gjat/temp-controller/pics/programmer board.jpg

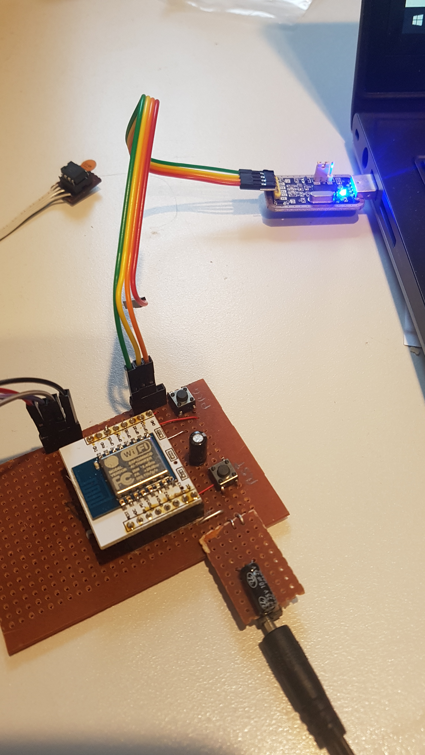
pics/programmer board.jpg
