gjat/temp-controller/pics/settings.png

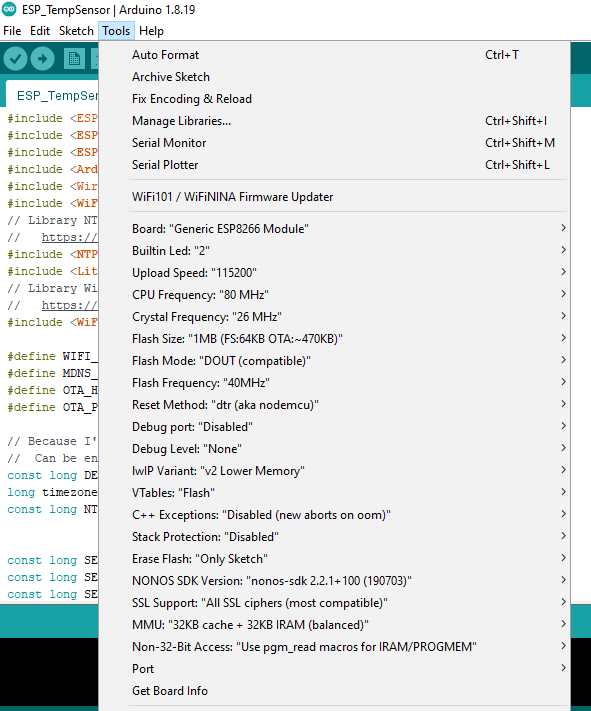
pics/settings.png
