gjat/temp-controller/(commit log)

2022-07-07 initial sensor test
2023-05-20 Update to provide resetting of min/max, and heater setpoints
    [ESP_TempSensor.ino]
2023-06-03 Add lots of new functionality. - OTA programming - Display temps in a chart - Add timezone to WifiManager configuration - Changed to record averages per half hour - Re-init temp sensor if not getting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
2025-02-19 Added posting to external web service Cleanup / refactored into C++ classes. Picture and schematic of the running PCB.
